ABDULRAHMAN-ALSAADI/scara-robot-arm/hardware/stl/README.md

# STL Files

The complete printable STL/CAD package is distributed through the project page on Cults3D:

https://cults3d.com/en/3d-model/gadget/scara-robot-arm-alsaadi

This folder is reserved for selected STL files if a separate GitHub release is published later.
