ABDULRAHMAN-ALSAADI/scara-robot-arm/hardware/cad/SolidWorks/README.md

# SolidWorks Source

The final mechanical design was developed in SolidWorks. Native `.SLDASM` and `.SLDPRT` source files can be placed here if a public source-CAD release is made later.

The complete downloadable 3D model is currently distributed through:

https://cults3d.com/en/3d-model/gadget/scara-robot-arm-alsaadi
