ABDULRAHMAN-ALSAADI/scara-robot-arm/docs/GALLERY.md

# SCARA Robot Arm — Project Gallery

This gallery collects the main CAD, mechanical, electronics, and physical-prototype visuals for the project.

## Complete CAD assembly

### Assembled perspective

Assembled perspective

### Transparent internal assembly

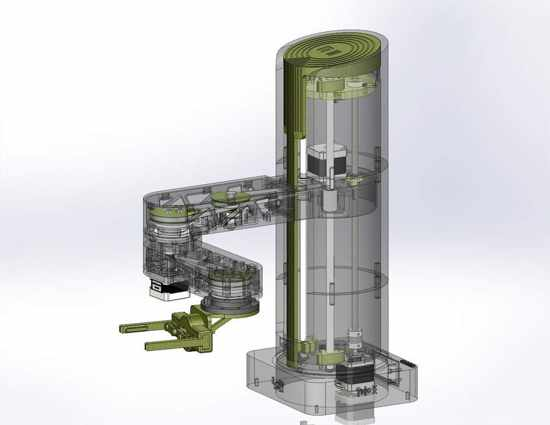
[picture p2: media/cad/scara-transparent-assembly.jpg]
Transparent assembly


### Side view

Side view

### Multi-view design sheet

Multi-view design

## Physical prototype

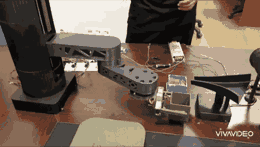
[picture p3: media/prototype/scara-arm-prototype.gif]
Physical SCARA prototype demonstration


## Mechanical mechanisms

### Z-axis components

Z-axis components

The vertical mechanism uses a lead screw for lifting and 10 mm steel shafts with LM10UU linear bearings for structural guidance.

### L1 to L2 belt transmission

L1 to L2 transmission

The first arm transmission uses two GT2 belt stages and a compound pulley arrangement to increase torque and reduce backlash.

### L2 to L3 belt transmission

L2 to L3 transmission

The third-axis motor is placed close to Joint 2 to reduce swing inertia, with belt transmission carrying motion to Joint 3.

## Electronics

Electronics wiring diagram

The control system combines an ESP32, DRV8825 drivers, NEMA 17 stepper motors, a servo gripper, limit switches, a 12 V motor-power rail, and a regulated low-voltage rail.

## Complete 3D model

The complete downloadable mechanical design is available here:

**[SCARA Robot Arm — Cults3D](https://cults3d.com/en/3d-model/gadget/scara-robot-arm-alsaadi)**
