ABDULRAHMAN-ALSAADI/scara-robot-arm/media/web-interface/web-ui-2.png

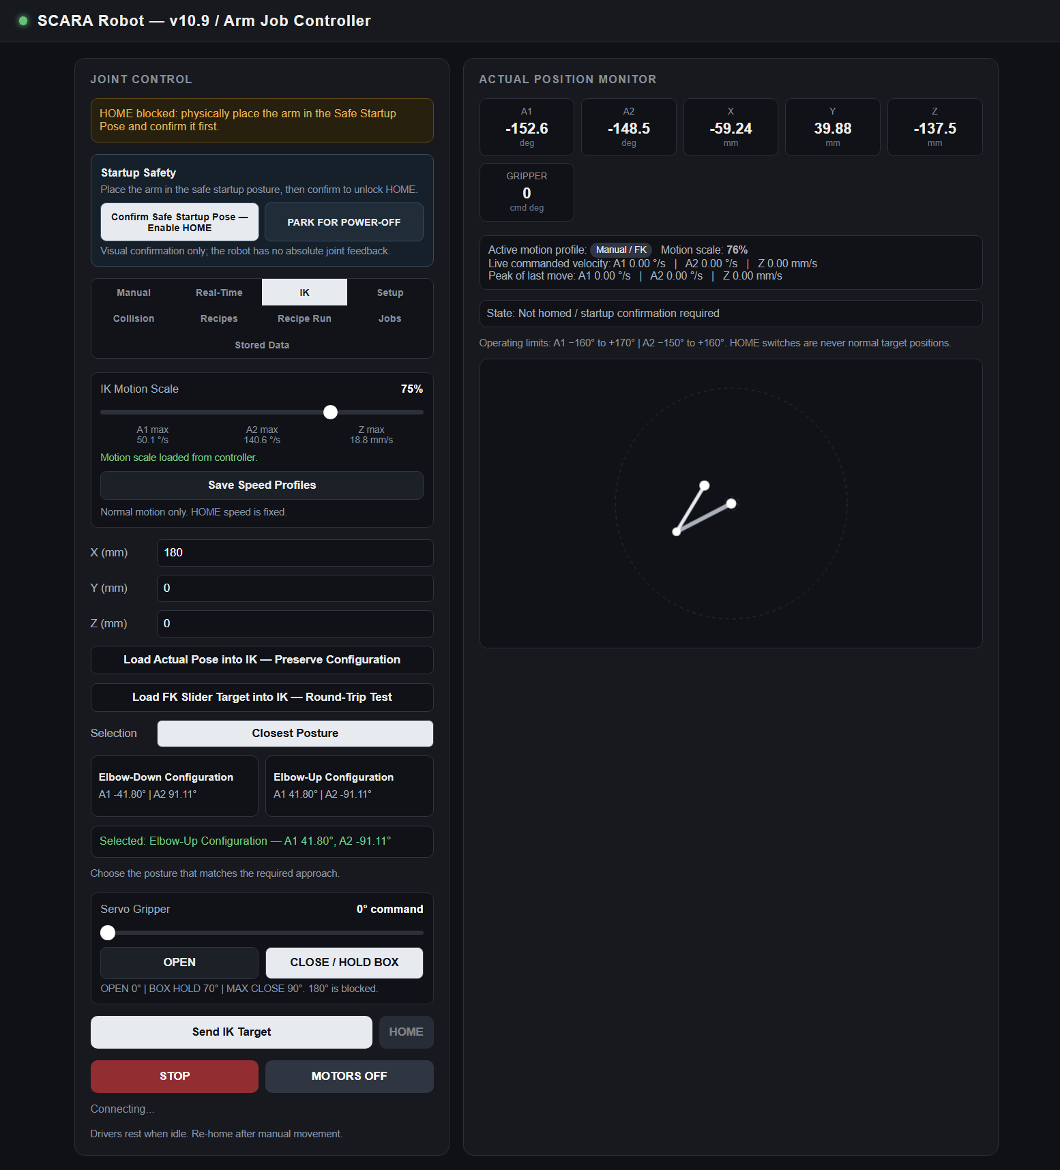
media/web-interface/web-ui-2.png
