ABDULRAHMAN-ALSAADI/scara-robot-arm/media/web-interface/web-ui-3.png

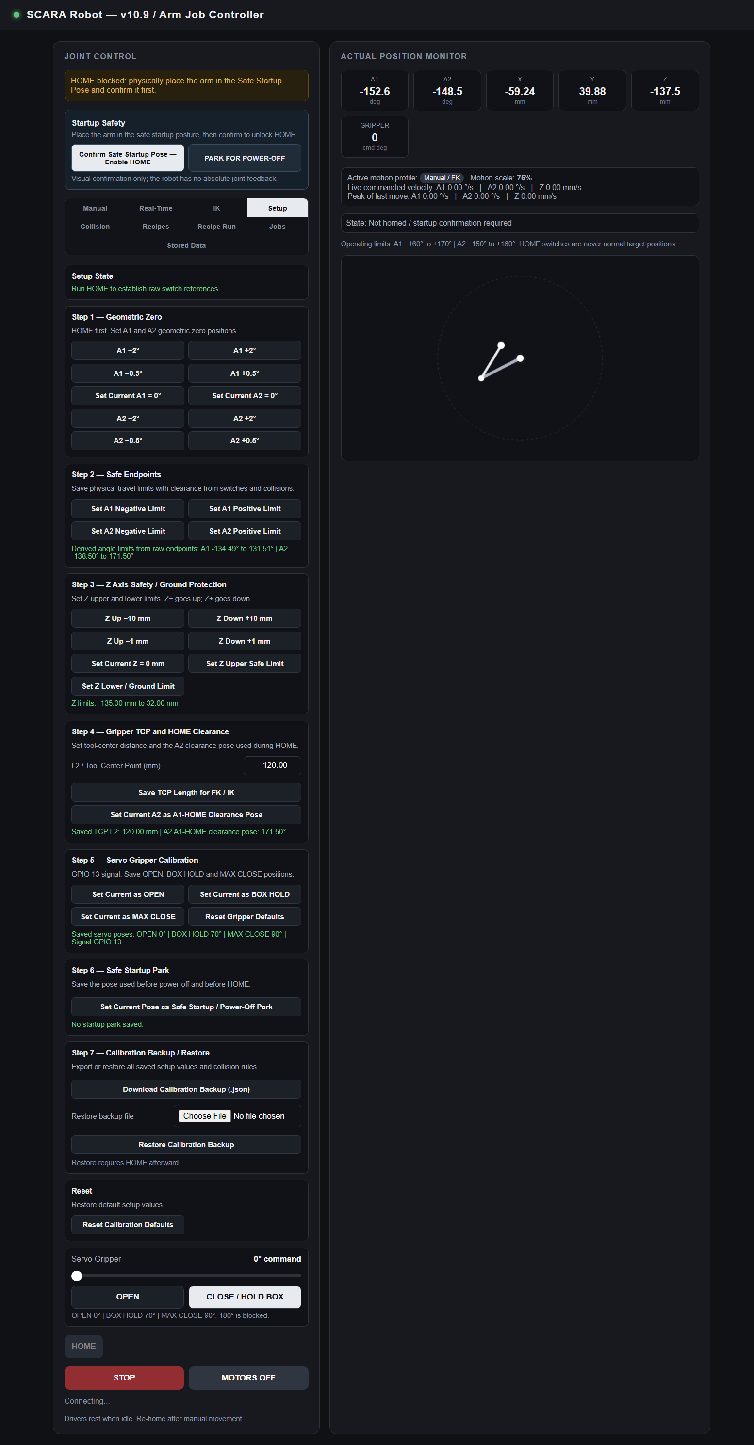
media/web-interface/web-ui-3.png
