ABDULRAHMAN-ALSAADI/scara-robot-arm/media/web-interface/web-ui-4.png

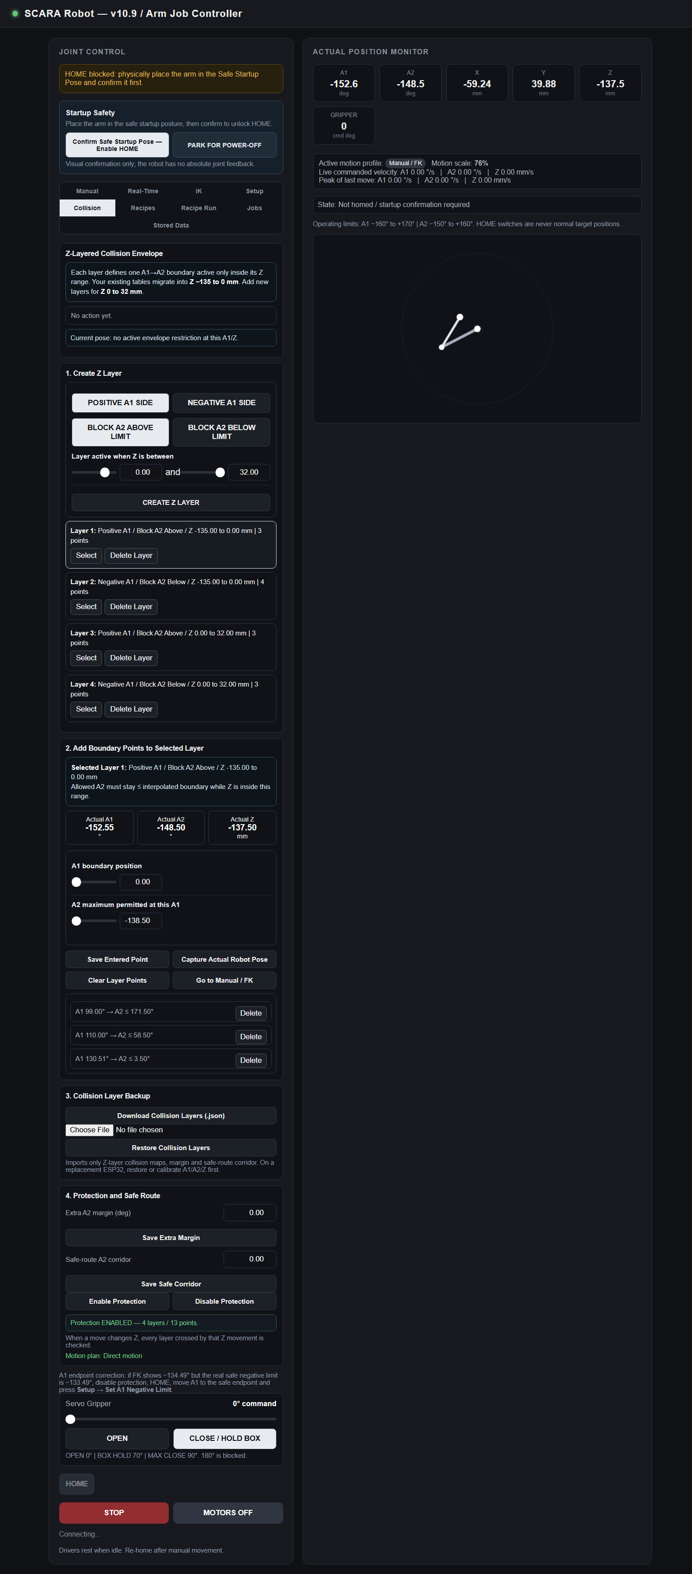
media/web-interface/web-ui-4.png
