ABDULRAHMAN-ALSAADI/scara-robot-arm/media/web-interface/web-ui-6.png

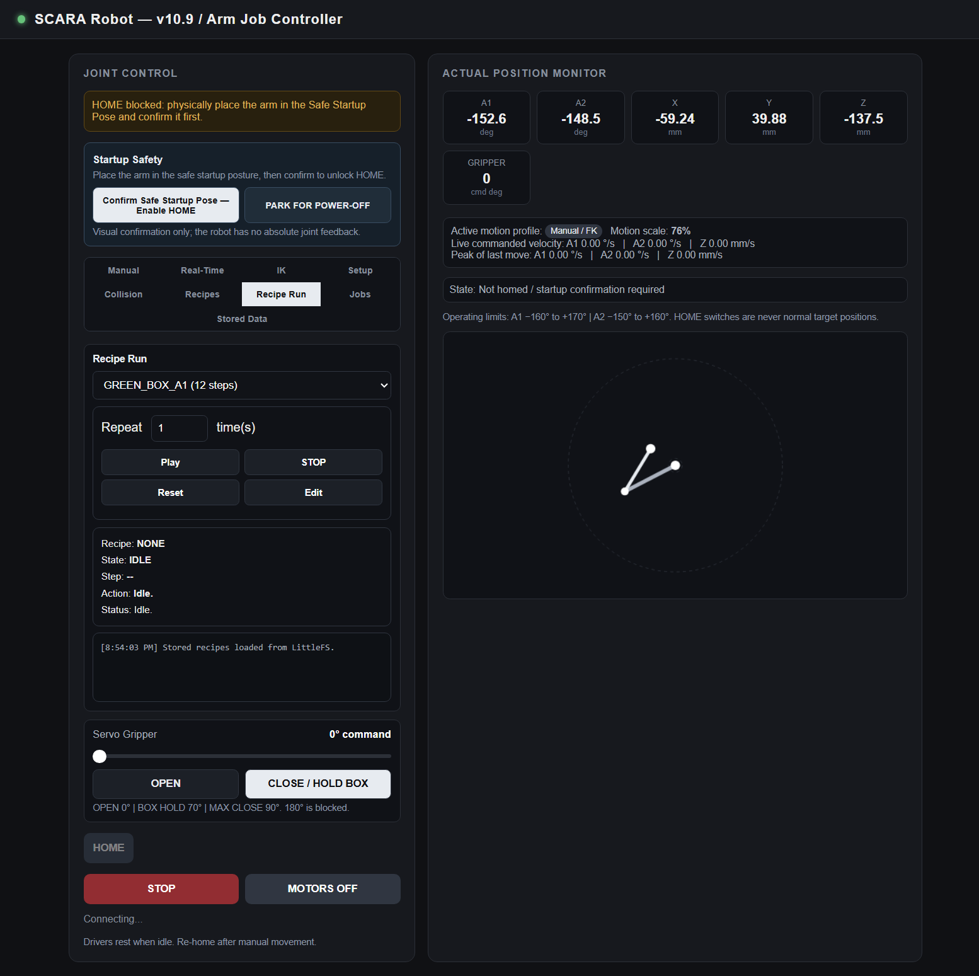
media/web-interface/web-ui-6.png
