ABDULRAHMAN-ALSAADI/scara-robot-arm/media/web-interface/web-ui-7.png

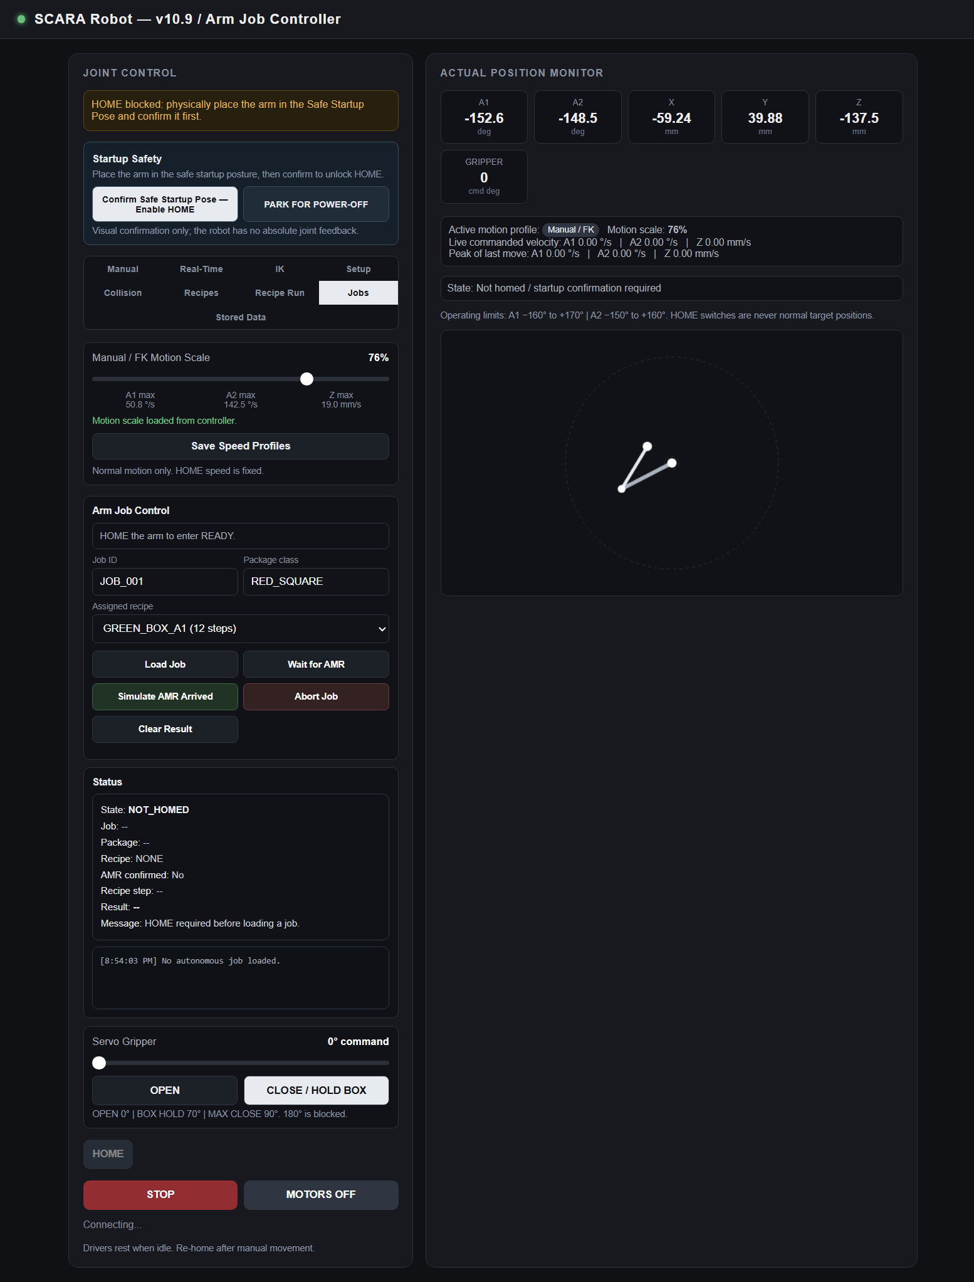
media/web-interface/web-ui-7.png
