ABDULRAHMAN-ALSAADI/scara-robot-arm/media/web-interface/web-ui-8.png

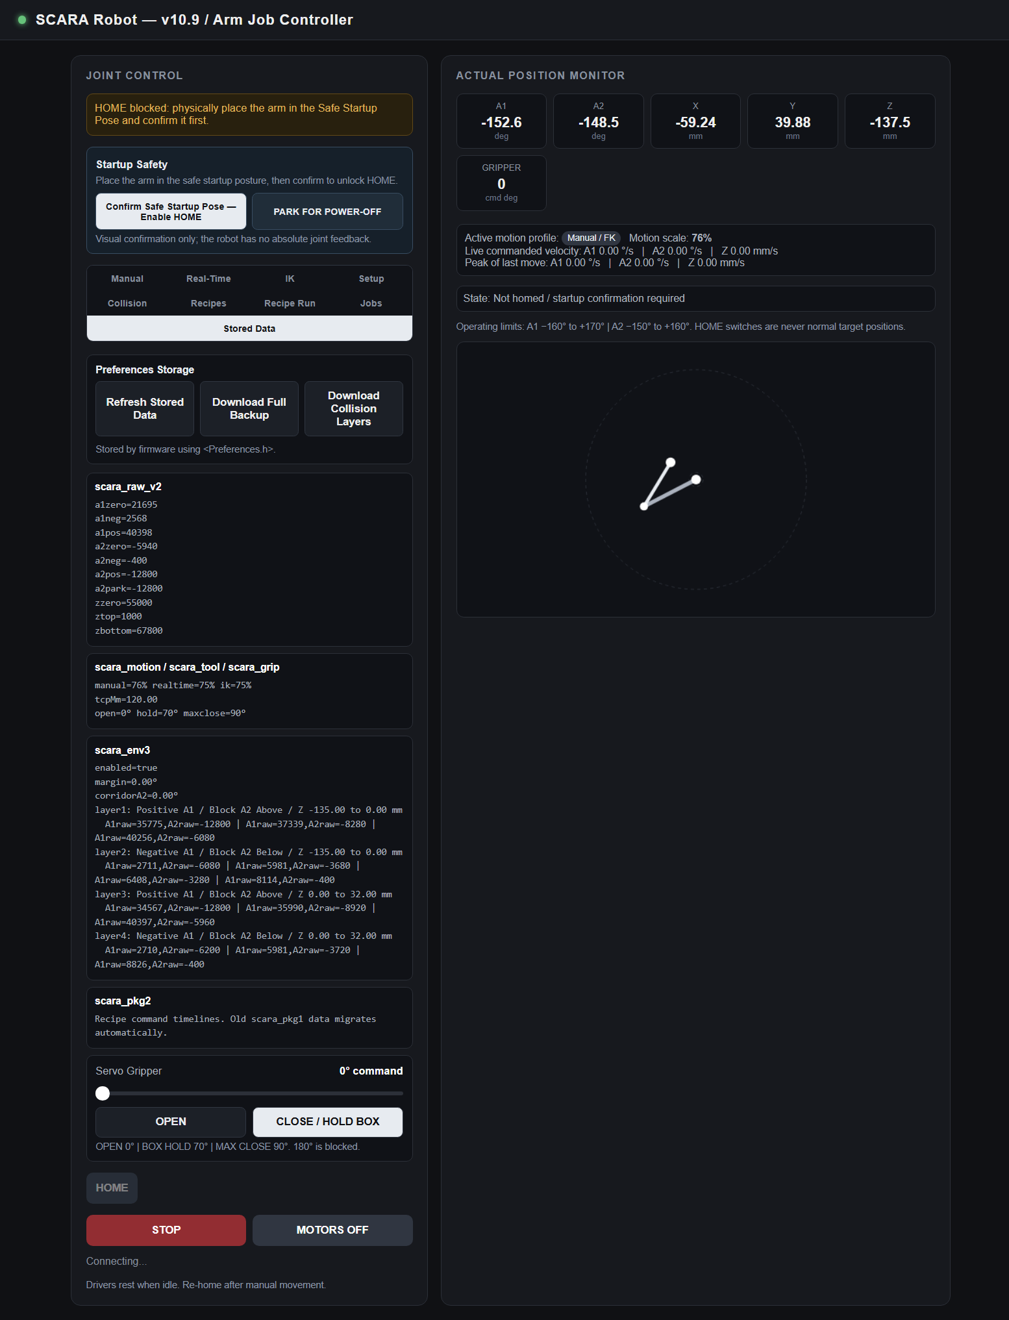
media/web-interface/web-ui-8.png
