ABDULRAHMAN-ALSAADI/scara-robot-arm/hardware/cad/STEP/README.md

# STEP Files

The complete final 3D design is available through the project's Cults3D page:

https://cults3d.com/en/3d-model/gadget/scara-robot-arm-alsaadi

This folder is reserved for selected neutral CAD files if they are published on GitHub later.
