ABDULRAHMAN-ALSAADI/scara-robot-arm/(commit log)

2026-08-08 Initialize SCARA robot arm repository
2026-08-08 Add bill of materials
2026-08-08 Add STL folder documentation
2026-08-08 Add SCARA CAD hero image
2026-08-08 Add SCARA transparent CAD view and prototype GIF
2026-08-08 Show CAD and prototype media in README
2026-08-08 Repair prototype GIF asset
2026-08-08 Correct SCARA axis count to 3-axis with servo gripper
2026-08-08 Correct SCARA mechanical and kinematic dimensions
2026-08-08 Correct SCARA geometry and kinematic dimensions
    [02_CalibrationAndStorage.ino, SCARA_ROBOT_ARM_CODE.ino]
2026-08-08 Add one-time workflow to correct Z-axis dimension
2026-08-08 Correct Z-axis vertical dimension to 485 mm
